imt2020532/Lookup-Table-Based-Design-of-High-PSRR-LDO-and-Automation-of-its-MOSFET-Sizing/README.md

Please wait for me to complete this code. As of now many of the things are hard coded and taken input manually. Will change this readme once changes are made.

Please change the paths of every csv file being used in the script! I have added the csv files here also in different directories.
