imt2020532/Lookup-Table-Based-Design-of-High-PSRR-LDO-and-Automation-of-its-MOSFET-Sizing/presentation.pptx

## Lookup Table Based Design of High PSRR LDO and Automation of its MOSFET Sizing

VL804 Analog Power IC Design
Anwit Suhas Damale IMT2020532
Nalamothu Sai Sampath MT2023525

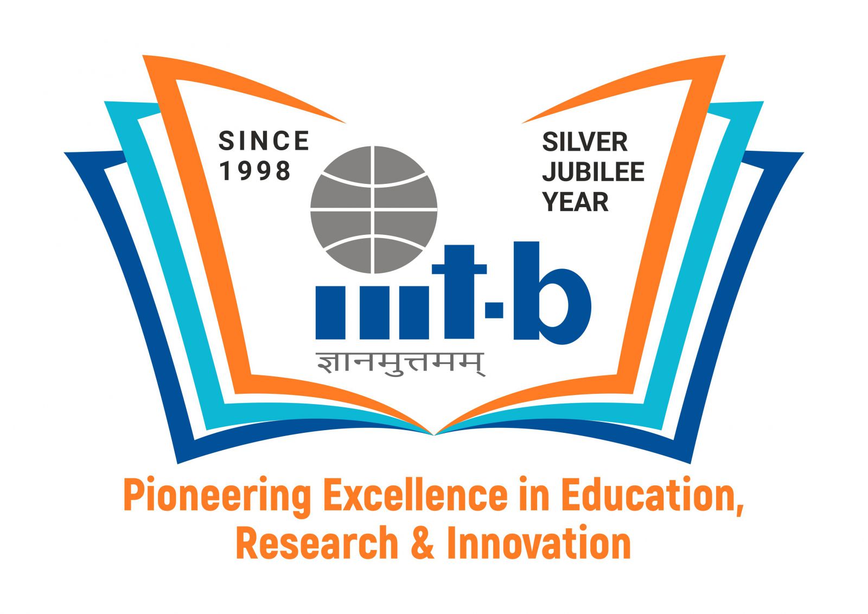
[picture p1: figure]

## Outline

1. Limitations of Square Law
2. gm/Id Methodology
3. LDO
4. Specification Table
5. Circuit Diagram
6. Design Flow
7. Limitations of gm/Id Methodology
8. Automation Design Flow
9. Results
10. Next Steps
11. References

## Limitations of Square Law

1. The square law fails to describe the weak inversion (sub-threshold) region.
2. The square law fails to describe strong inversion (saturation) region when short channel effects are taken into consideration.
3. Since there is a difference between an actual transistor behavior and the simple square law model, any square-law driven design optimization will be far off from simulation results

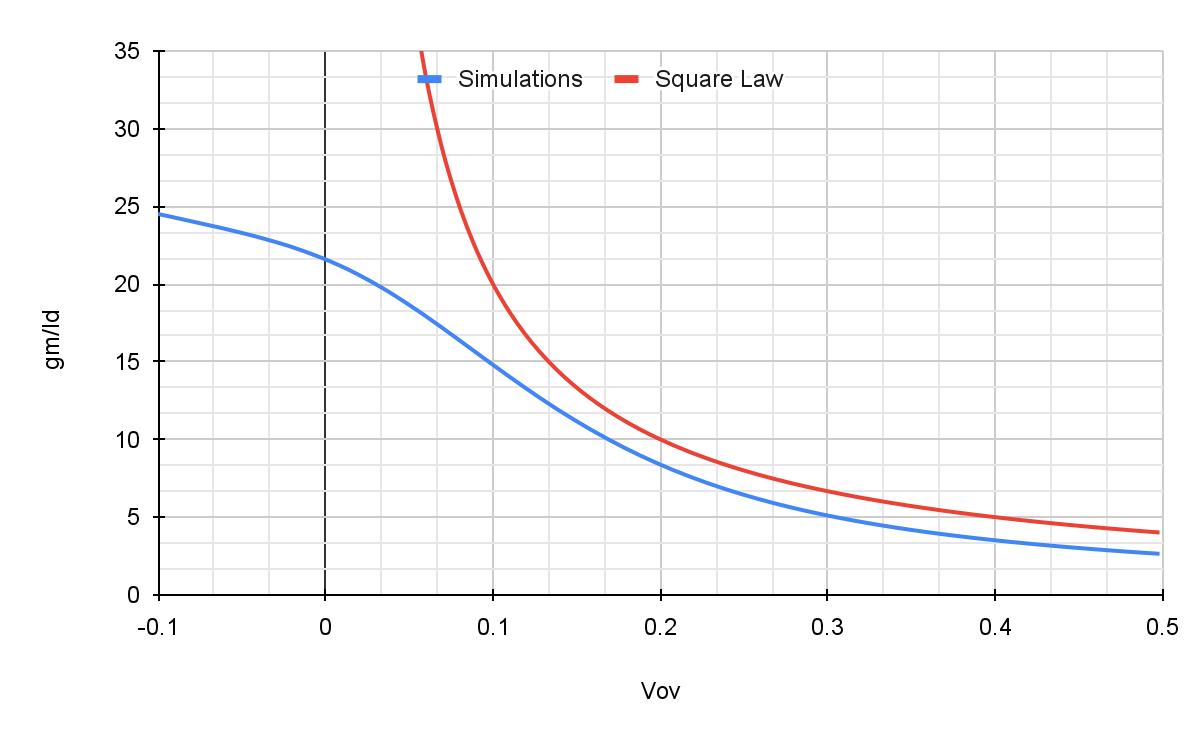
[picture p2: figure]

## Slide 4

gm/Id v/s Vov plot comparison for different technology nodes for their minimum lengths

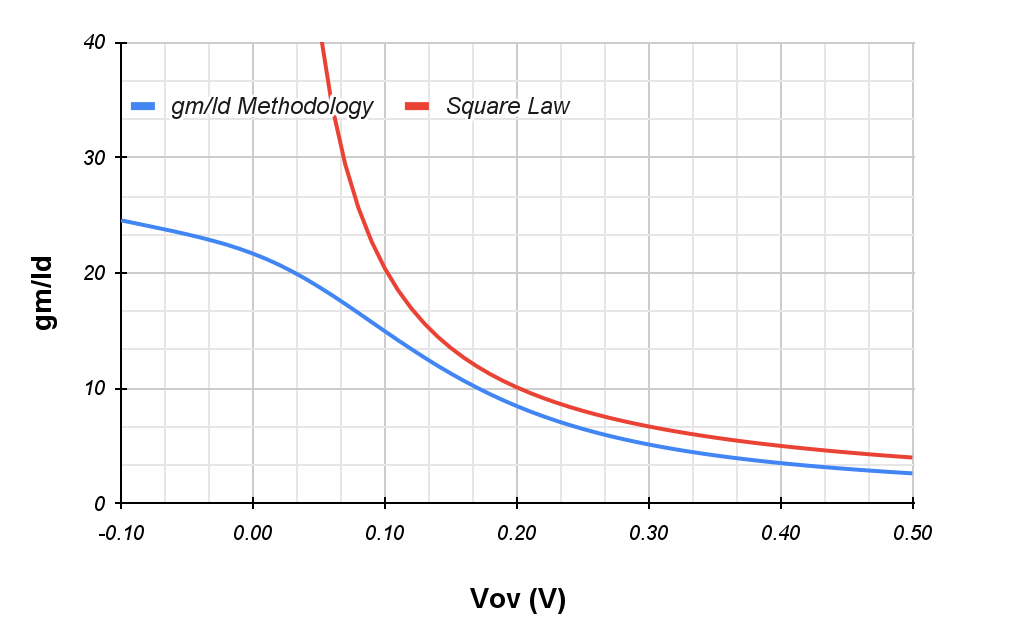
[picture p3: figure]

180nm technology node
Lmin = 180nm

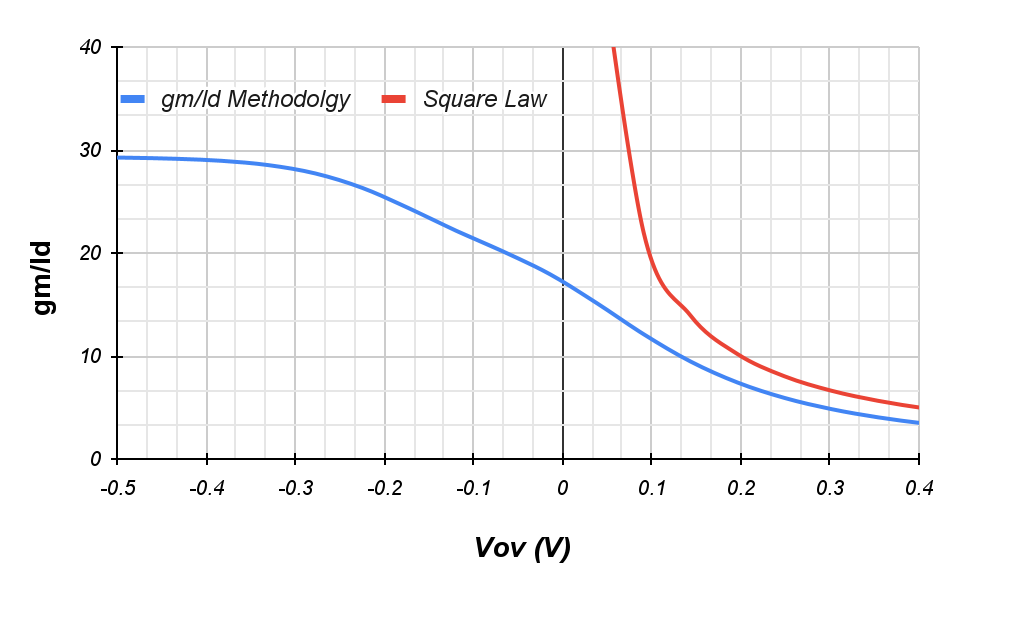
[picture p4: figure]

110 nm technology node
Lmin = 110nm

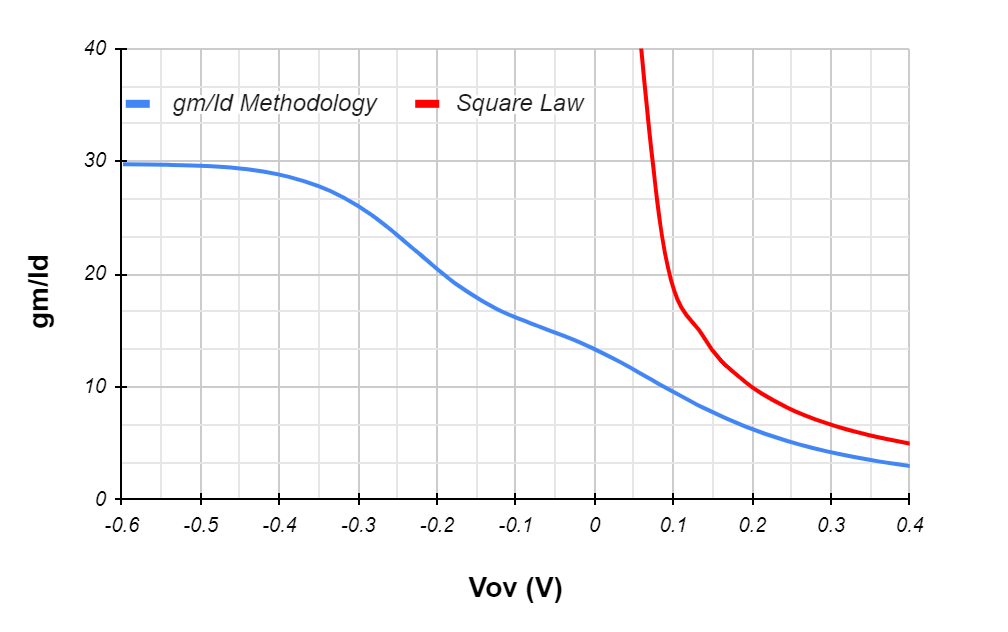
[picture p5: figure]

45nm technology node
Lmin = 45nm

- For a lower technology node of its respective minimum length the difference between gm/Id methodology and square is very large

## Slide 5

Comparison of Error (%) of gm/Id v/s Vov for different technology nodes

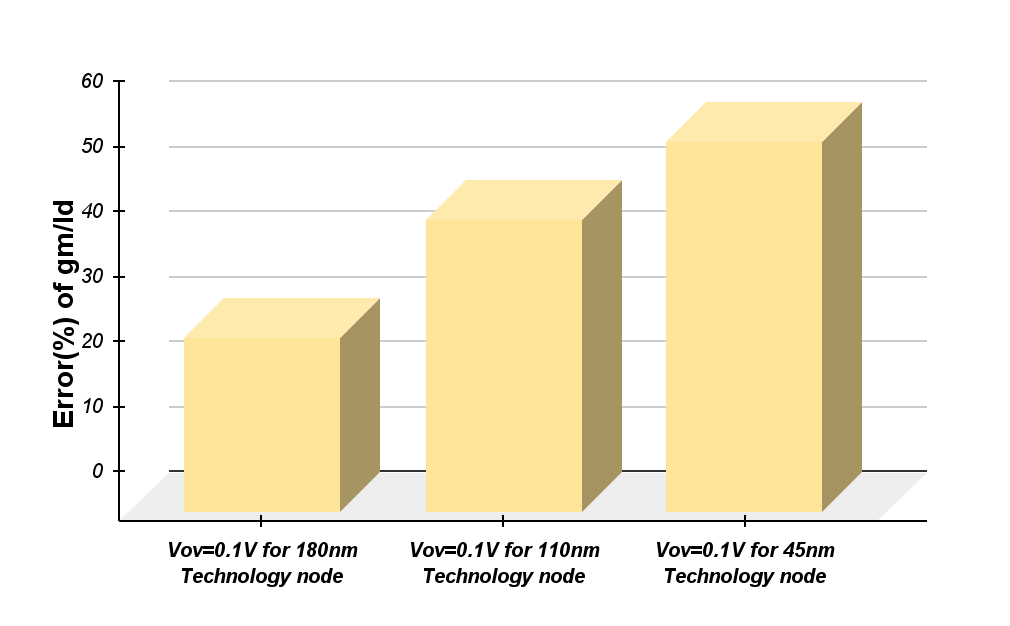
[picture p6: figure]

- For a lesser Vov value, the error (%) of gm/Id value of gm/Id methodology and Square Law is very high

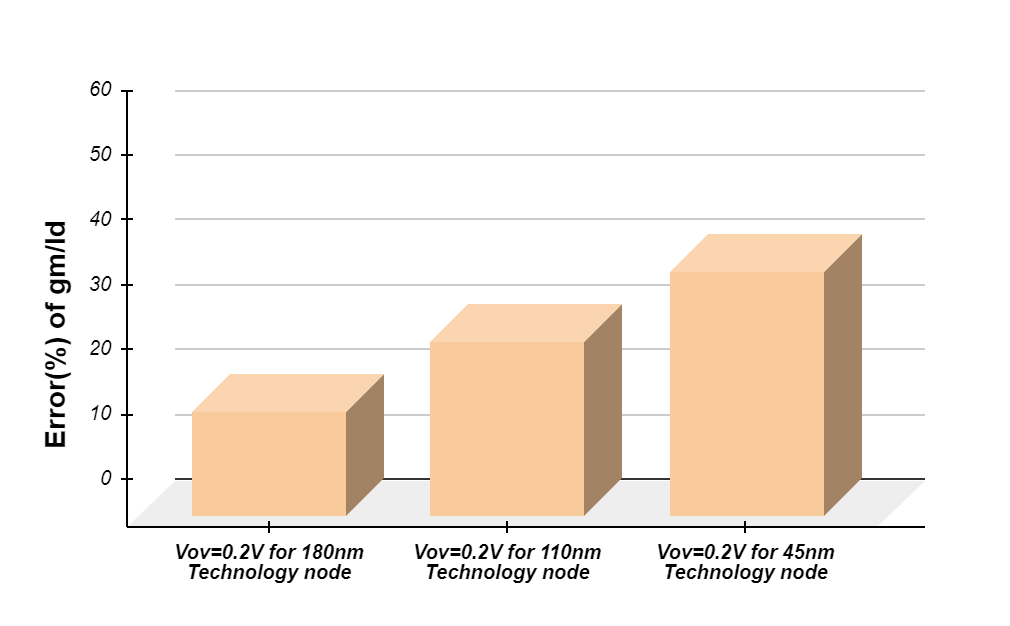
[picture p7: figure]

## Slide 6

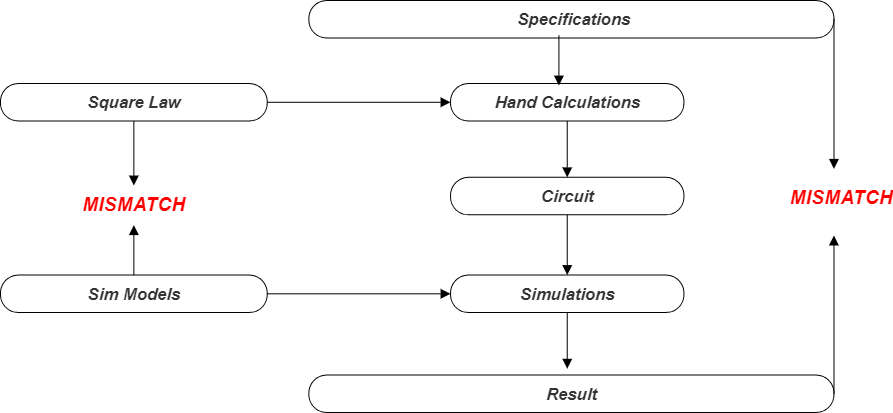
[picture p8: figure]

Square Law based Design

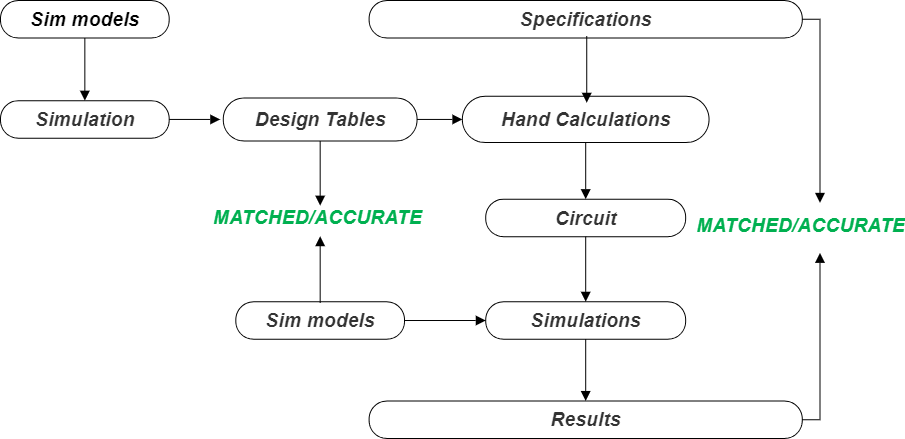
[picture p9: figure]

gm/Id methodology based Design

- gm/Id methodology gives more accurate results than Square Law

## gm/Id Methodology

gm/Id is a measure of the efficiency to translate current (i.e., power) into gm (i.e., gain). The greater gm/Id, the greater gm is for a fixed Id. gm/Id is interpreted as a measure of the “gm enhancement efficiency”.
1. It is strongly related to the performances of analog circuits.
2. It describes about the device region of operation.
3. It provides a tool for calculating the transistors dimensions.
4. The method exploits the transconductance over dc drain current ratio ( gm/Id) relationship versus the normalized current [Id/(W/L)].

## Slide 8

Advantages of gm/Id Methodology
1. gm/id curve is generated from SPICE simulation, which is linked to the actual measurement data
- Better match to the fabricated one
1. gm/id value does not rely on any model equation
- Avoid the design uncertainties
1. gm/id Value has fixed shape regardless of transistor length.
2. gm/id curve is valid all over the transistor operating range.
3. gm/id method can reduce the design and optimization effort a lot.
4. Once selecting one point from gm/id curve, with another design parameter the third parameter can be easily determined.

## Figure of merits (or) Performance metrics

1.Trans-conductor Efficiency: (Should be high)
It is the efficiency of the MOS transistor to translate given current into an equivalent transconductance.
TE = gm/Id
2. Intrinsic Gain: gm*ro
3.Transit Frequency (or Unity Gain Frequency):
WT=gm/Cgg
It is the maximum frequency beyond which MOS transistor will not act as amplifier.
All the above mentioned FOM's and Id/W are independent of widths.

## Slide 10

gm/Id plot comparison for different technology nodes of same length = 180nm

180nm technology node

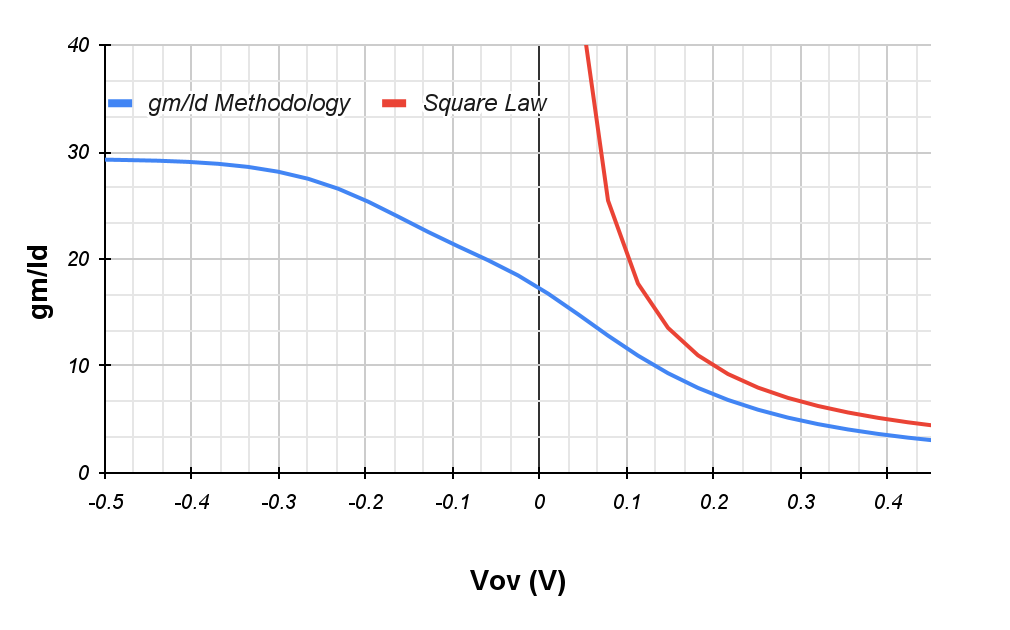
[picture p10: figure]

110 nm technology node

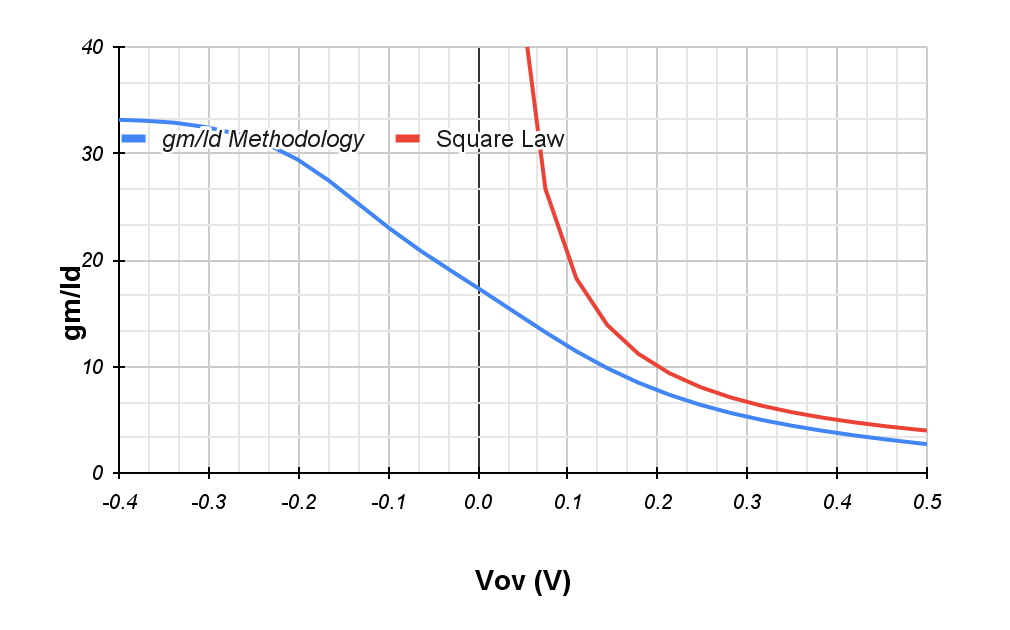
[picture p11: figure]

45nm technology node

- For any technology node if length increases the narrowness between gm/Id methodology and Square law gets decreased

## LDO

A voltage regulator with a small difference in voltage between input and output is called an LDO regulator. LDO stands for low dropout; an LDO regulator is a type of linear regulator with a low input-output voltage differential.

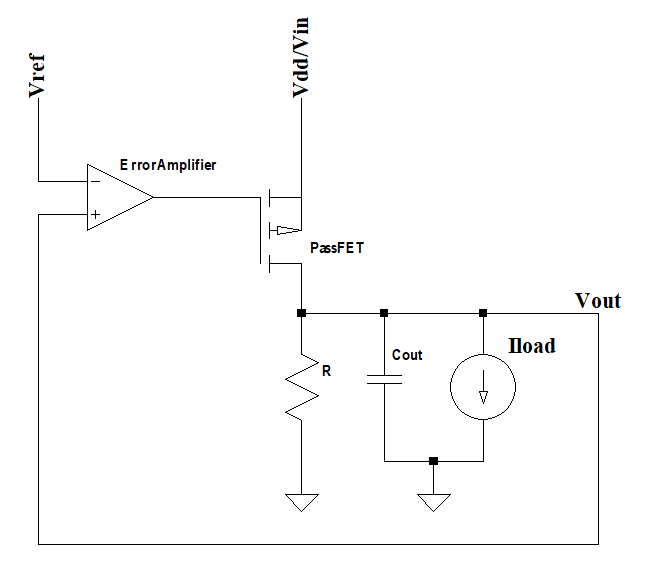
[picture p12: figure]

Linear regulator with unity feedback

## Regulator Performance Parameters

DC Regulation:
1. It is measure of an error in output voltage.
2. For good dc regulation high gain error amplifier, low offset error amplifier and a constant vref w.r.t. process, voltage and temperature is required.

## Slide 13

Line regulation:
1. It is a measure of error in output voltage due to change in the input supply (line)
Line Regulation = ΔVout / Δvin (at low freq)
Load regulation:
1. It is a measure of error in output voltage with change in load current.
Load Regulation = ΔVout / ΔIout
1. Cumulative high gain of error amplifier and passfet is desired for the good load regulation i.e less change in vout with change in load current.

## Slide 14

Line transient:
1. When there is up and down step change in line supply, it result in over and undershoot respectively in the vout of regulator. The reason is the feedback doesn’t respond quickly.
Line Transient = ΔVout / Δvin (step change)
1. For a good regulator, ΔVout because of line transient should be less than 5% of Vout and tsettle will be calculated when it will reach to 1% of Vout.
2. For a good line transient generally a large capacitor at output is used. Also feed forward from line is taken with feedback to decide the gate control of passfet and high bandwidth regulator is made for loop to respond faster.

## Slide 15

Load transient:
1. It is a measure of error in output voltage with step change in load current.
Load Transient = ΔVout / Iload (step change)
1. When there is up and down step change in load, it result in under and overshoot respectively in the vout of regulator.
2. The reason is the feedback doesn’t respond quickly and the capacitor draws and gets respectively the extra current.
3. Large capacitor and high bandwidth regulator is useful in less load transient.
4. Large Capacitor will act as transient filter because any fast change at output will be filtered out by it.

## Slide 16

Power supply rejection ratio (PSRR):
1. It is the ability to reject any change in vout w.r.t. ac change in vin.
PSRR = ΔVout/ΔVin
1. Large output capacitor value will allow less ripple to go at load. It is calculated in dB. A large –ve dB PSRR value is good.
Efficiency:
Efficiency w.r.t. Power = Pout/(Pout+Ploss)
Quiescent Current:
1. It is an internal current consumption of the regulator at no load condition. It should be as low as possible for better current efficiency.
2. Iq should be as minimum as possible from the design along with correct operation
Efficiency w.r.t. Current = Iout/(Iout+ Iq)

## Specification Table

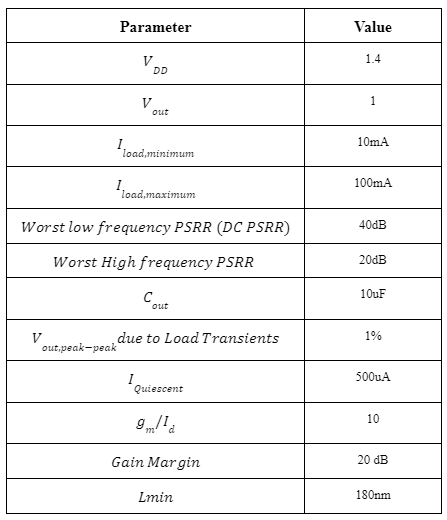
[picture p13: figure]

## Circuit Diagram

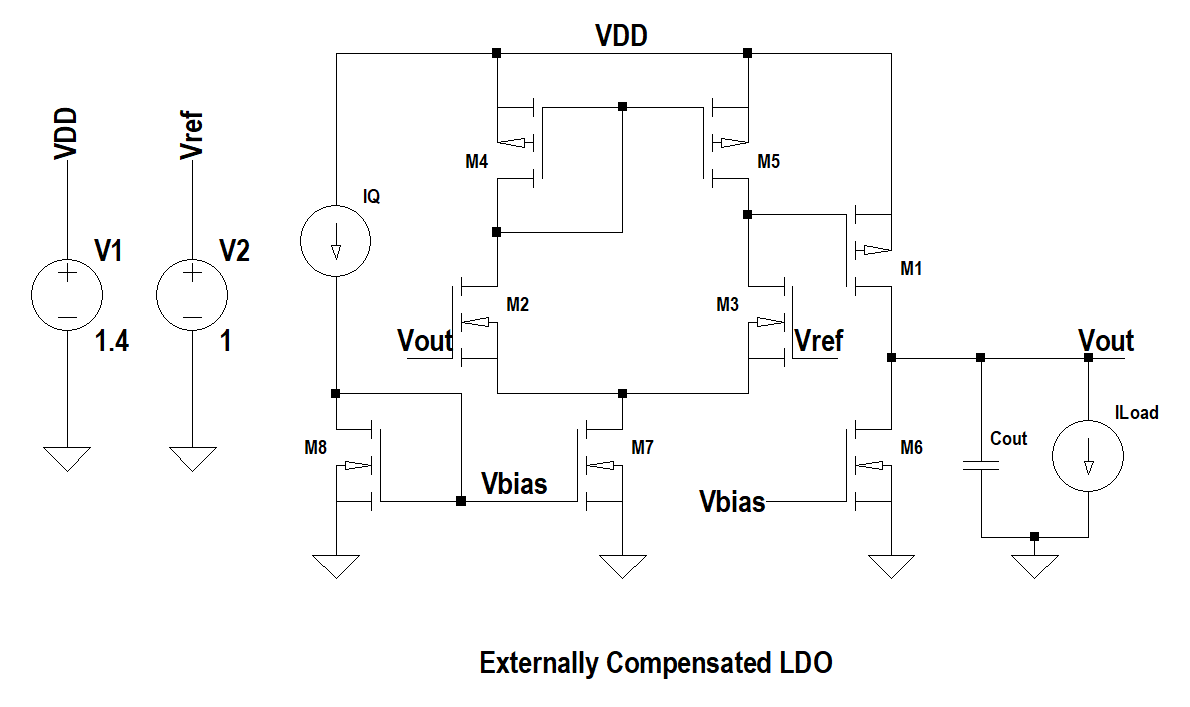
[picture p14: figure]

## Design Flow

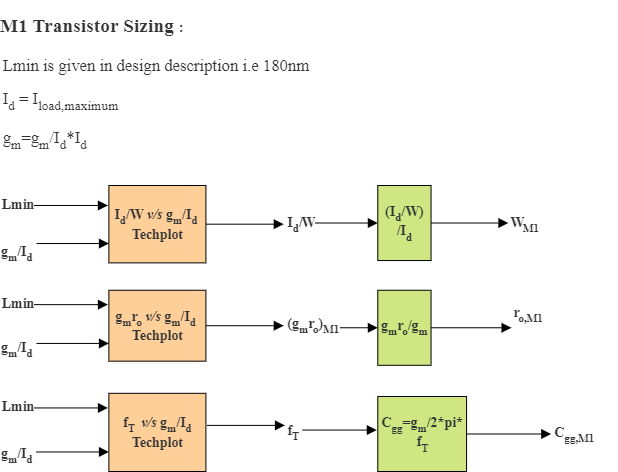
[picture p15: figure]

## Slide 20

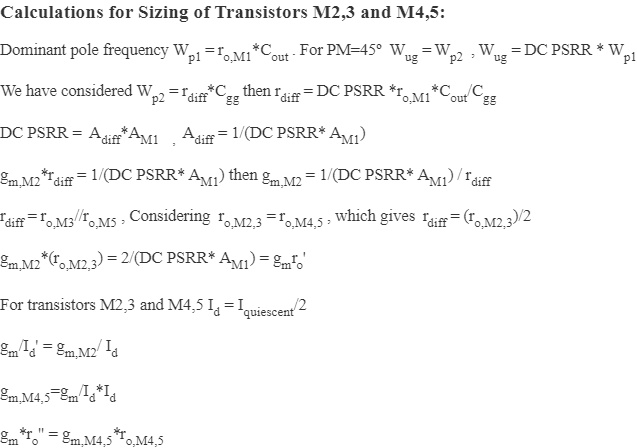
[picture p16: figure]

## Slide 21

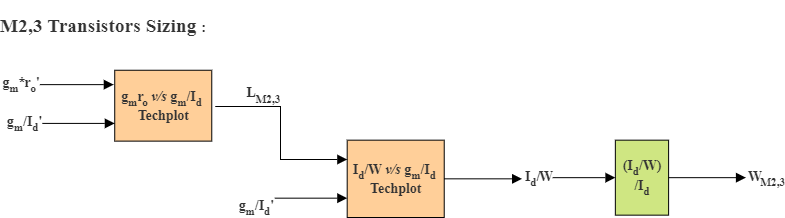
[picture p17: figure]
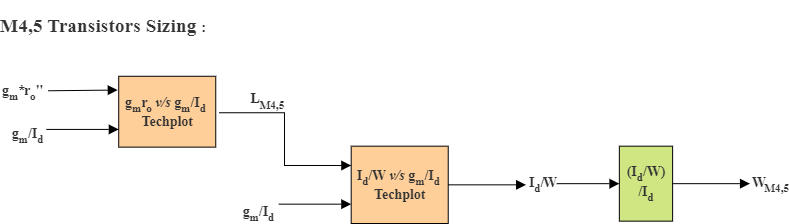
[picture p18: figure]

## Slide 22

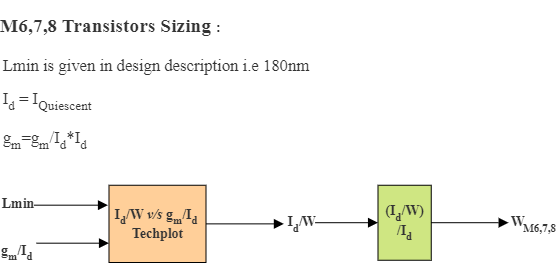
[picture p19: figure]

## Limitations of gm/Id Methodology

1. If we go for lower technology nodes the dependency of width comes into the picture where in general the parameters (FOM’S) are independent of width .
2. We are fixing the value of Vds for a certain value which in turn leads Vds mismatch in device and tech-plots.

## Automation Design Flow

- We are using the TechPlot_Sim_Data_180nm_VDS_0p4V.xlsx file as our tech-plot file.
- As of now we need to change the format of this file for our inputs to the automated Python script.
- The exact .csv format files and directories can be seen in the flow below.

## Slide 25

Format of Saving plots

Directories

Directories

Gm by Id vs gmro

csv files

M1 plot

L = 180 nm

Gm by Id vs Id by W

M2 plot

Tech-plot

Gm by Id vs gmro

L = 360 nm

Gm by Id vs Id by W

M1 to M8

For all Lengths

## Block Diagram of the Script

Script

Tech-plot

Specifications

Look-up table

Optimal Lengths and Widths of M1 to M8 Transistors

## Automation Design Flow - Script Sequence

The sequence in which the code works is :-
- First M1 Width, inputs are specification value gm by Id = 10.
- Second will be getting Width and Length of M2 and M3. The input will be both Gm_diff/I_diff and Gm_diff*ron_diff.

## Automation Design Flow - Script Sequence

The sequence in which the code works is :-
- Input will be gm/I_diff and gm*ron, then we will get the most suitable length.
- Then input gm/i_diff will give us Id/W as output. Now use specification table and get W.

## Automation Design Flow - Script Sequence

The sequence in which the code works is :-
- Similarly we get Width and Length of M4 and M5.
- We get Width of M6, M7 and M8 the same way we got M1 Width.

## Automation Design Flow - Code Functions

- This function performs linear interpolation to estimate the y-value corresponding to a given x-value within a set of data points (x_data, y_data) provided in CSV format.

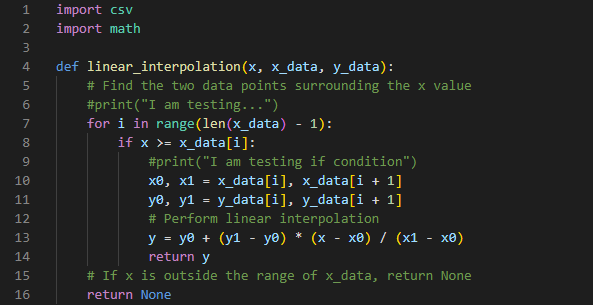
[picture p20: figure]

## Automation Design Flow - Code Functions

- This function calculates the minimum Euclidean distance between a point (x, y) and a curve defined by a set of points (x_curve, y_curve).

## Automation Design Flow - Example

- Use Specification table for giving inputs at every step and the look-up table for the formulae based calculations.

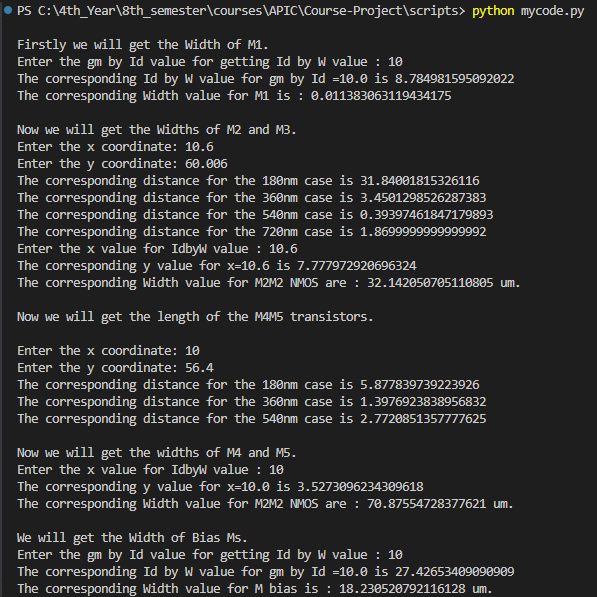
[picture p21: figure]

## Limitations of the Script

- The format of the tech plot needs to be manually changed.
- The inputs should be looked up for in the specifications table instead of getting them automatically.
- The intermediate formulae based calculations are not yet put in the code.

## Results

Transistor Sizing Comparison

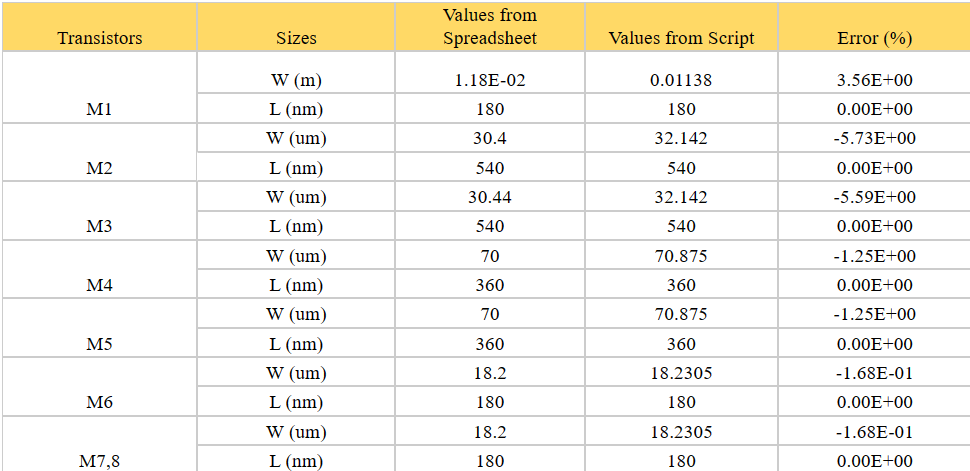
[picture p22: figure]

## Comparison of values generated from spreadsheet and scripting

## Next Step

- Making the script more automated with including formulae based calculations coded in it.
- Interpreting the tech plot format internally in the code itself.
- Taking inputs from specification table automatically.
- Making the entire process open source.

## References

1. F. Silveira et al. "A gm/ID based methodology for the design of CMOS analog circuits and its application to the synthesis of a silicon-on insulator micropower OTA," IEEE J. Solid-State Circuits, Sep. 1996, pp.1314-1319.
