imt2020532/Lookup-Table-Based-Design-of-High-PSRR-LDO-and-Automation-of-its-MOSFET-Sizing/DMC_2024.pdf

# Design and Automation Methodology of a Wideband, High-PSRR LDO using Device Look-up Tables

Sai Sampath¹

, Anwit Damale²

, Sakshi Arora³

and Manikandan R.R.⁴
Electronics and Communication Department International Institute of Information Technology Bangalore, India {saisampath.nalamothu, anwit.damale, sakshi.arora, manikandanrr}@iiitb.ac.in

Abstract—This work presents a Look-up Table (LuT)-based methodology for designing wideband, high Power Supply Rejection Ratio (PSRR) Low Dropout Regulators (LDOs). The proposed methodology has been automated using a Python script to produce optimal sizes for all LDO transistors. A high-PSRR LDO has been designed in 180-nm CMOS technology utilizing this methodology and its automation script. The LDO achieves a DC-PSRR of -60 dB, with a worst-case PSRR of -

### 36 dB across frequencies and load currents. Across the stability

performance metrics, an error percentage of less than 2.5% is achieved between calculated and simulated values. Therefore, this approach addresses the limitations of the traditional MOSFET square-law model while retaining analytical insights and design intuition, reducing design iterations and shortening the overall design cycle.
Index Terms—Look-up Table (LuT) methodology, LDO, Linear Regulators, wideband power supply rejection, CMOS design, Python script, PSRR, analog-design automation, gm/Id
I. INTRODUCTION

Using MOSFET square law for designing analog circuits can lead to significant differences between theoretical design calculations and simulated circuit behavior. This difference is more pronounced at sub-90-nm nodes and for low overdrive voltages. The gm/Id methodology [1], also known as the lookup table (LuT)-based design approach, offers a robust solution to size transistors for the given MOS Figures of merit, namely gm/Id, Id/W, ft and gmro, as it relies on the actual device characterization data [2]. However, different analog circuit blocks with various performance metrics require different LuTbased design flows [3]. Furthermore, the vast data set available with technology characterization can add complexity to LuTbased methods and demand automation incorporated into the overall design flow.
This work demonstrates a design and automation methodology for wideband high PSRR LDOs using technology LuTs. The proposed workflow follows two steps: In step 1, algorithms 1 and 2 take the design specification and derive the MOS FOMs. In step 2, these FOM values and technology LuTs are fed to the automation script, which automates the entire design flow to obtain optimum sizes for all transistors. Following this performance-specific design and automation flow, a strong correlation between circuit-design calculations and simulation results is achieved.

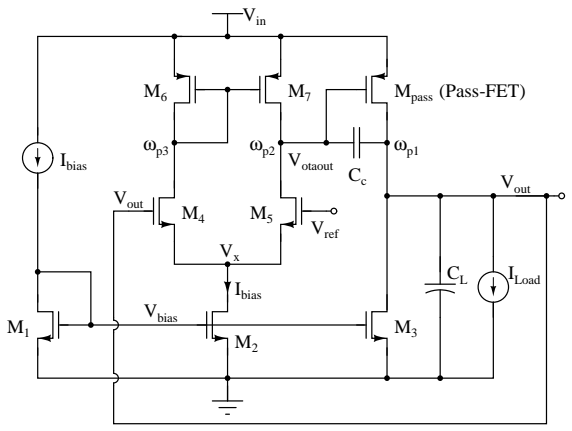
[picture p23: figure]
Vout; Vref; Ibias; Mpass; ILoad; Vin; Vbias; (Pass-FET); Votaout

Fig. 1. Externally-compensated PMOS-based LDO

The presented methodology enables creating and sharing standardized design flows, promoting collaboration among designers and, as a result, contributing to open-source design effort [4] [5]. This work uses automation scripts to streamline device sizing and reduce design time while preserving the analytical insights necessary for design accuracy [6]. Section II-A/B/C describes Algorithms 1 and 2, which are used to derive transistor FOMs from given performance specifications. Section II-D presents Algorithms 3 and 4, which take as input the above-derived FOMs and technology LuTs to produce optimum device sizes. Section III presents the correlation between the calculated and simulated performance of a wideband high PSRR LDO designed using the presented methodology. Section IV summarizes and concludes the work.

II. DESIGN-FLOW OF A HIGH-PSRR EXTERNALLY-COMPENSATED LDO USING DEVICE LUTS
Figure 1 shows an externally-compensated LDO with a PMOS Pass FET (also called PMOS-based LDO). The following sections discuss the step-by-step description of the proposed design methodology:
A. Sizing the pass transistor, Mpass
The LDO pass-FET is sized to support maximum load current and (gm/Id = 10), which is a proxy for Vov = 200mV from conventional square-law paradigm. Minimum channel length, Lmin = 180nm is used to minimize the device area. Algorithm 1 shows the detailed steps to compute the width of the pass-FET, Wpass, and also to calculate its small-signal parameters: gmpass, (rOpass = rout,p1), and Cggpass. In this step, the pass-FET intrinsic gain and output-pole frequency, ωp1, are also calculated.
B. Worst-case load condition
Determining the dependence of LDO small-signal performance metrics on load conditions is critical to this design flow and is summarized via the equations below.
The loop gain, ALG, is expressed as the product of the gain of the pass transistor, Apass and the error-amplifier gain, Adif f and is given by:

ALG

DC = (gmpassrOpass) · [gm4(rO5 k rO7)] (1)

where gmpass · rOpass is the intrinsic gain of the pass FET, gm4 and (rO5 k rO7) are the transconductance and output resistance of the error-amplifier, respectively. The dominant pole, set by the output stage of the LDO, is given by:

ωp1 ≈

1

rOpassCL

∝ ILoad | (2)

The non-dominant pole, ωp2, is set by the error-amplifier output and is given by:

ωp2 =

1

(rO5 k rO7) · Cggpass
(3)

The unity-gain bandwidth, ωugb, is proportional to the gm of the pass transistor and error-amplifier gain, Adif f :

ωugb ∝

gmpass · Adif f
CL
∝

p
ILoad | (4)

As the load current, ILoad, increases, the dominant pole, ωp1, and the unity-gain bandwidth, ωugb, increase and move closer to the second pole at the error-amplifier output, ωp2. Therefore, the worst-case phase-margin of an externally-compensated LDO is at heavy or maximum load current.

C. Sizing of error-amplifier transistors
The DC-PSRR of PMOS LDO can be approximated [7] as,
PSRRDC = −20 log10(ALG,dc) | (6)

where ALG,dc is the DC loop gain. From the given DC-PSRR specification, ALG,dc can be evaluated from equation
(6) which is then used to calculate Adif f and the other stability metrics as shown in Algorithm 2. As an example, to achieve a phase-margin of ≥ 45°:

ωp2 =

ALG,dc

ωp1|Heavy
=

ALG,dc
1
rOpass|Heavy·CL

(8)

Algorithm 2 illustrates the design flow for the NMOS input pair (M4,5), where gm/Id is set by the Ibias specification,

Algorithm 1 Sizing the Pass FET (Mpass)
Given the load circuit parameters CL and Iload,max, 1: Set (gm/Id) and Lpass to the following values,
- Set

gm
Id
= 10
- Set Lpass = Lmin = 180-nm 2: Lookup Tables (LuTs):
- Extract transistor F oM’s at

gm
Id
= 10 from the
following LuT’s,
– Intrinsic gain LuT → (gm · ro) versus

gm
Id
– Transit frequency LuT → fT versus

gm
Id
– Current density LuT →

Id
W

versus

gm
Id
3: Computation block:
- Calculate pass-FET small signal parameters from the extracted FoM values,

– gmpass =

gm
Id
- Iload,max

– rOpass =

h
(gm·ro)

gmpass i
and Cggpass =
gmpass
fT

– ωp1 =

1
rOpass·CL

– Wpass =

h
Iload,max

IdW

i

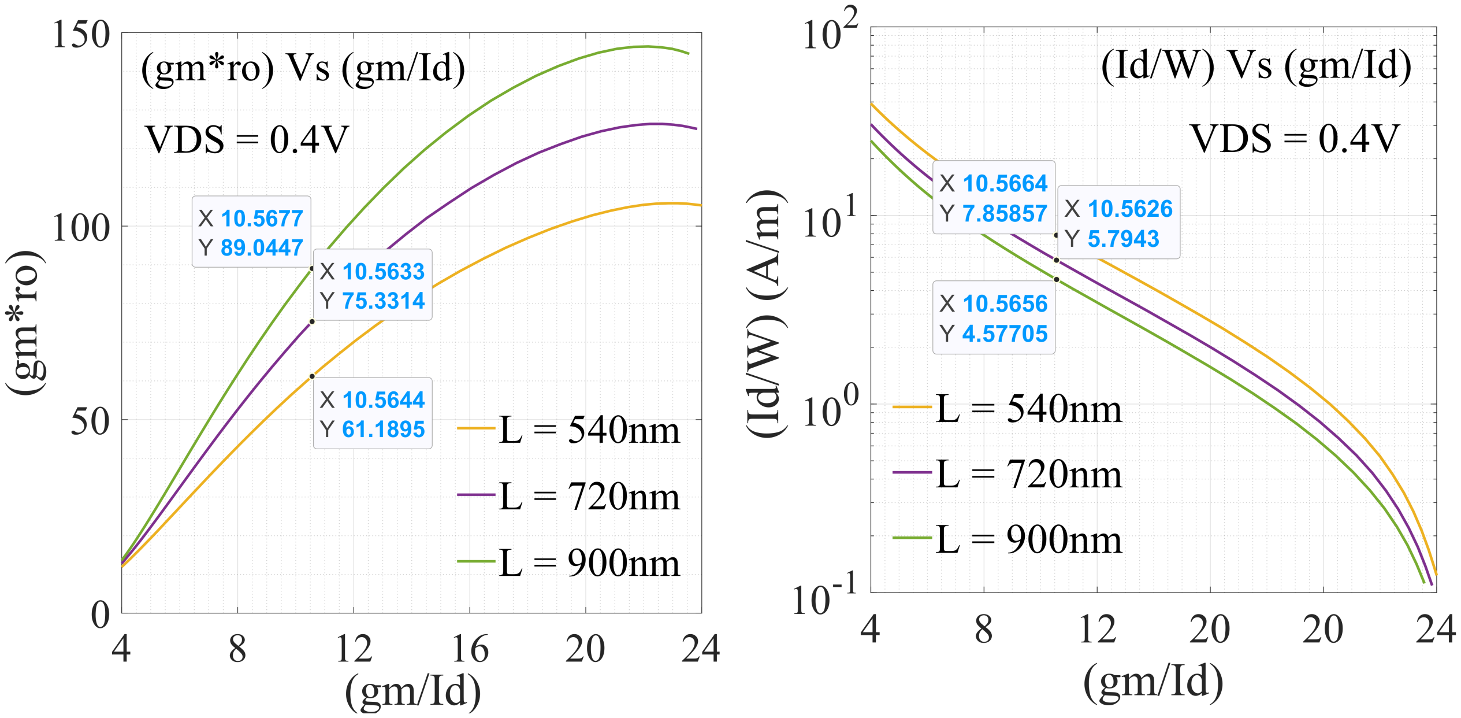
[picture p24: figure]

(a) (b)

Fig. 2. Device Lookup Table (LuT) plots generated for an NMOS transistor in 180-nm CMOS process technology.

and gm4,5, which is derived from the pass-FET intrinsic gain and the error-amplifier output resistance.
For the PMOS-transistor load, M6,7, the flow follows a similar approach to that of the pass-FET. Id,6,7 current is set to (Ibias/2) and (gm/Id) ratio matched to that of pass-FET. However, in the case of the PMOS load, we utilize technology plots where the drain-source voltage (Vds) is approximated as (Vth + Vov) ≃ 0.6V in the design example.
In this design, for the bias transistors, M1,2,3, the lengths and gm/Id are chosen to be same as that of M4,5. Transistor widths, W1,2,3 are computed using the steps outlined in Algorithm 1.
D. Automation script for MOSFET sizing
Figure 3 shows the block level description of the ‘LDO-(gm/Id)’ design flow script. The script takes design speci-

Algorithm 2 Sizing the error-amplifier transistors (M4,5) 1: Input parameters:

- gmpass · rOpass
- Cgggpass
- Output pole frequency, ωp1
- Ibias or IQ
2: Computation block:
- Calculate the error-amplifier transistors’ small signal parameters from the given input parameters,

– Adif f

DC =

h ALG

DC
(gmpass·rOpass)

i

– ωugb =

ALG

DC · ωp1

– (ro5||ro7) =
1

Cgggpass·ωugb

– ωp2 =

h
1

(ro5||ro7)·Cgggpass i

– gm4 = gm5 =

h
Adiff
(ro5||ro7)

i

– (gm · rO) = -gm4 · 2 · (rO5||rO7)

–

gm
Id
=

h
gm4

(Ibias/2) i

3: Lookup Tables (LuTs):
- Find the channel length of transistors M4,5 to meet the calculated (gm · rO) requirement.
- Extract transistor F oM’s at the calculated

gm
Id
from
the following LuT’s,
– Transit frequency LuT → fT versus

gm
Id
– Current density LuT →

Id
W

versus

gm
Id
4: Transistor Width (M4,5):
- Calculate W4,5 → W4,5 =

h
(Ibias/2)

IdW

i

fications and technology LuTs as inputs, and gives out the optimum dimensions for all LDO transistors. The LuTs are in the form of a ‘CSV’ file with the following MOSFET FOMs: intrinsic gain, (gm · ro), current density (Id/W), and transit frequency (fT ), characterized against the trans-conductance efficiency (gm/Id).
Algorithm 1 & 2 are included as computational blocks in this design-automation script.
As a next step, device aspect ratios need to be computed for a derived gmro or ft FOM. To perform this, we need to access technology plots (shown in Fig.2), which can be either limited or too vast to handle. In order to address these concerns, this script uses two functions:
- The ”linear interpolation” function is useful to estimate an intermediate value from a given set of discrete data points. In the ’LDO-gm/Id’ design flow, this function interpolates the FOM values for a given gm/Id in a limited channel-length techplot set. For example, in Fig.2 the function will find gmro values for multiple finer length steps at a gm/Id = 10.56.
- The ”distance between a point and a curve” function

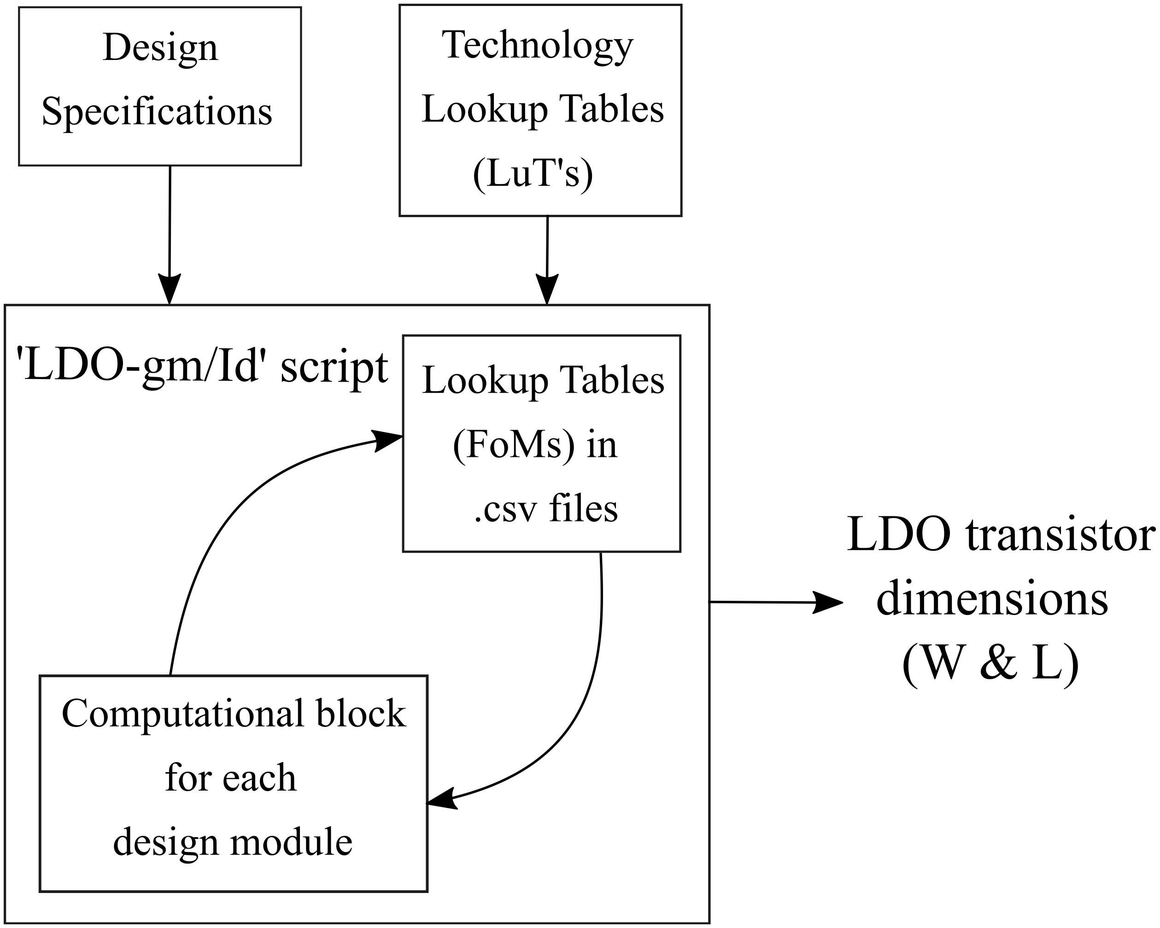
[picture p25: figure]

Fig. 3. Block-level description of the ‘LDO-(gm/Id)’ design flow script.

calculates the Euclidean distance between a target FOM point and a set of data points on a curve. For example, the function will find the optimum channel length for the derived gmro.

In summary, to find transistor channel length for desired intrinsic gain (gm · ro), the script does the following: Using the LuT data of ‘gmro vs. gm/id’ the interpolation function estimates gm·ro for a given (gm/Id) at all channel lengths. The distance-to-curve function then calculates the distance between the target and all the gm·ro points and then selects the channel length with the smallest distance to target gm·ro curve. ‘LDO-(gm/Id)’ design flow script is implemented using Python which is shared here: Github link (https://github.com/imt2020532/Lookup-Table-Based-Design-of-High-PSRR-LDO-and-Automation-of-its-MOSFET-Sizing.git) [8].

Algorithm 3 Linear Interpolation
1: Input parameters:
- input point, x →

gm
Id
- x-coordinates, xdata → array of

gm
Id
values
- output point, y → interpolated (gm · rO)
- y-coordinates, ydata → array of (gm · rO) values 2: Process:
3: for each i from 1 to -len(xdata) − 1
do
4: | if x ≥ xdata[i] then
5: | Set x0 = xdata[i], x1 = xdata[i + 1]
6: | Set y0 = ydata[i], y1 = ydata[i + 1]
7: | Perform linear interpolation,
8: | y = y0 +

h
| (y1−y0) (x1−x0) · (x − x0)

i

9: | Return y
10: | end if
11: end for
12: Output:
| • y → (interpolated y-coordinate for the given x)

III. SIMULATION RESULTS AND DISCUSSION
In order to validate the proposed LDO design automation methodology using LuTs, an example design with specifica-

Algorithm 4 Distance Between a Point and a Curve 1: Input parameters:
- x-coordinate of the input point, x →

gm
Id
- y-coordinate of the input point, y → (gm · rO)
- x curve → array of x-coordinates of the curve
- y curve → array of y-coordinates of the curve 2: Process:
3: Initialize min distance = ∞
4: for each i from 1 to len(x curve) do
5: | Calculate distance between point (x, y) and curve point
| (x curve[i], y curve[i]):
6: distance =

p
| (x curve[i] − x) 2 + (y curve[i] − y)
| 2
7: | if distance < min distance then
8: | Update min distance = distance
9: | end if
10: end for
11: Output:
| • min distance (minimum distance between the point
| and the curve)

TABLE I
TECHNOLOGY LOOKUP TABLE PARAMETERS AND DIMENSIONS OF LDO TRANSISTORS (M1−7) & Mpass.
Transistor | gm/Id (1/V ) | gmrO | Id/W (A/m) | fT (GHz) | L (µm) | W (µm)
Mpass | 10 | 32.361 | 8.834 | 5.76 | 0.18 | 1132
M4,5 | 10.56 | 75.33 | 5.799 | 1.49 | 0.72 | 4.31
M6,7 | 10 | 60 | 9.04 | 5.96 | 0.18 | 2.7
M1,2,3 | 10.56 | 75.33 | 5.799 | 1.49 | 0.72 | 8.62

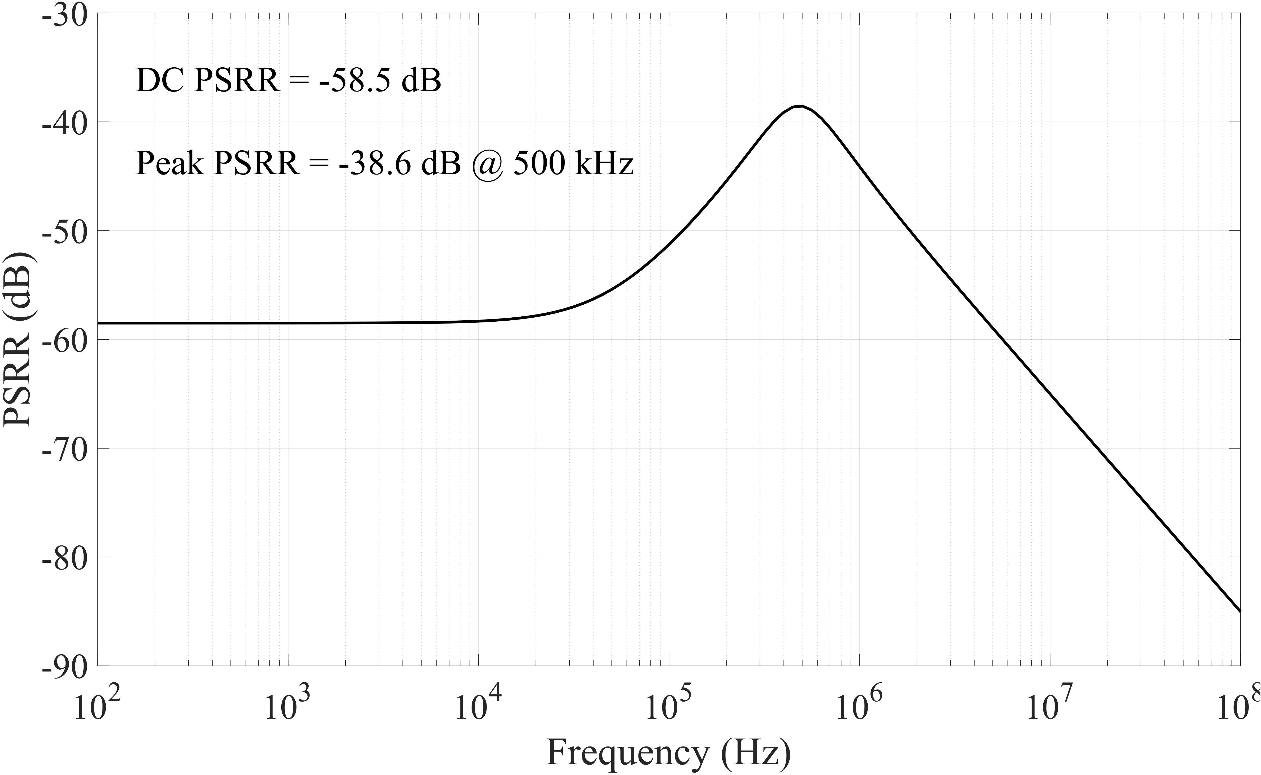
[picture p26: figure]

Fig. 4. Simulated PSRR performance, Vin = 1.4 V , Vout = 1.0 V , ILoad = 10 mA, Ibias = 50 µA, and CL = 1 µF.

tions Vin = 1.4 V , Vout = 1 V , ILoad = 10 mA, and a wideband PSRR of < −30dB, is designed and simulated in a 180-nm CMOS process technology. Figure 1 shows the schematic of the PMOS-based LDO. The pass-FET (Mpass) is sized to support a maximum load current of 10 mA. Error amplifier transistors (M4−7) and CL are designed to meet the wide-band PSRR specifications, as discussed in section II. Bias transistors (M1−3) are sized for a drain-to-source current of 50 µA, with its length and
gm/Id
kept same as that of M4,5. Table I

TABLE II
COMPARISON OF CALCULATED AND SIMULATED STABILITY METRICS WITH ERROR PERCENTAGE
| Calculated | Simulated | Error (%)
Adiff · Apass DC loop gain = | 1000, 60 dB | 1000, 60 dB | 0%
1 fp1 ≈ 2πrOpassCL | 489 Hz | 485 Hz | 0.82%
h 2π(rO5||rO7)Cggpass i 1 fp2 ≈ | 489 kHz | 478 kHz | 2.3%
fugb ≃ 0.787 · fp2 | 384 kHz | 379.6 kHz | 1.16%
Phase margin | 51.8o | 51.5o | 0.58%

shows the technology LuT parameters and the dimensions for LDO transistors, obtained from the ‘LDO-(gm/Id)’ design flow script. Pass-FET and the LDO circuit are estimated to occupy an on-chip area of 400 µm²

and ≃ 490µm²
respectively.
Table II shows the calculated and simulated stability metrics. Figure 4 shows the simulated PSRR performance of the LDO, with a high DC-PSRR of -58.5 dB, and with a peak PSRR of -38.6 dB at 500 kHz. The LDO supports a maximum load of 10 mA with an output capacitor of 1 µF, maintaining stability across load conditions. Table II validates the correlation between calculated and simulated performance of the proposed ‘LDO-(gm/Id)’ design methodology. The comparison is tabulated for DC loop gain, pole frequencies, unity-gain frequency and phase margin. Across these metrics, the predicted stability performance has an error of < 2.5%.

IV. CONCLUSION
The ’LDO-gm/Id design methodology’ presented in this work achieves a strong correlation of performance between design calculations and simulation results. The demonstrated design and automation flow is adaptable to advanced technology nodes and reduces number of analog design iterations. With the emerging usage of open-source PDKs, methodologydriven designs like this work, can be shared more widely, benefiting the broader analog IC-design community [8].

REFERENCES

[1] F. Silveira, D. Flandre, and P. Jespers, “A (gm/id) based methodology for the design of cmos analog circuits and its application to the synthesis of a silicon-on-insulator micropower ota,” IEEE Journal of Solid-State Circuits, 1996.
[2] P. Jespers, “The (gm/id) methodology, a sizing tool for low-voltage analog cmos circuits,” Springer, 2010.
[3] P. G. A. Jespers and B. Murmann, “Systematic design of analog cmos circuits using pre-computed lookup tables,” Cambridge University Press, 2017.
[4] B. Murmann, “Democratizing ic design: The story of a new movement and the launch of the sscs pico program [society news],” IEEE Solid-State Circuits Magazine, 2021.
[5] J. Marin, J. Gak, C. A. Rojas, A. H. Wilson-Veas, N. Calarco, M. Miguez,
A. R. Oliva, and N. Salvador, “Open-source multilevel converter power ic design and test,” IEEE Design Test, 2024.
[6] B. Murmann, “Practical aspects of script-based analog design using precomputed lookup tables,” in 2024 IEEE International Symposium on Circuits and Systems (ISCAS), 2024.
[7] V. Gupta and G. Rincon-Mora, “A low dropout, cmos regulator with high psr over wideband frequencies,” in 2005 IEEE International Symposium on Circuits and Systems, 2005.
[8] An example wideband PSRR LDO circuit designed using the proposed methods in this work and the Python scripts can be found in the following Github, link. (https://github.com/imt2020532/Lookup-Table-Based-Design-of-High-PSRR-LDO-and-Automation-of-its-MOSFET-Sizing.git)
