imt2020532/Lookup-Table-Based-Design-of-High-PSRR-LDO-and-Automation-of-its-MOSFET-Sizing/specs.xlsx

parameters | value | Unit
Vdd | 1.4 | V
Vout | 1 | V
I_load,min | 10 | mA
I_load,max | 100 | mA
Worst Low Frequency PSRR (DC PSRR) | 40 | dB
Worst High Frequency PSRR | 20 | dB
C_out | 10
V__out_peak_to_peak due to load transients | 1% | uA
I_quiescent(less than value given) | 500
