imt2020532/Lookup-Table-Based-Design-of-High-PSRR-LDO-and-Automation-of-its-MOSFET-Sizing/LTSpice/LDO_Load_Transient_Analysis.asc

C2: cap; {Co}
I1: current; {ibias}
Iload: current; PULSE(10m 100m 1u 200n 200n 1m 2m 10)
M1: nmos; nmos292p; L=Linput W=Winput
M2: nmos; nmos292p; L=Linput W=Winput
M3: nmos; nmos292p; L=0.18u W=18.2u
M4: pmos; pmos292p; L=Lload W=Wload
M5: pmos; pmos292p; L=Lload W=Wload
M7: nmos; nmos292p; L=0.18u W=18.2u
M8: nmos; nmos292p; L=0.18u W=18.2u
MPass: pmos; pmos292p; L=0.18u W=Wpass
V1: voltage; 1.4; AC 1
V2: voltage; 1
Named nets: 0, Bias, OUT, Vdd, Vref, OTAout
.include models_292p.txt
;.ac dec 20 10 1G
;.op
.tran 4m
.param ibias=500u
.param Linput=540n Lload=360n
Please set the parameters in all the .param statements below
.param Wload=70u
.param Winput=30.4u
.param Wpass=11800u
Also, set the capacitance values
;step param Co 10u 100u 10u
.param Co=10u
