imt2020532/Lookup-Table-Based-Design-of-High-PSRR-LDO-and-Automation-of-its-MOSFET-Sizing/LTSpice/LDO_loopgain_Analysis.asc

C2: cap; 10µ
C3: cap; 1
I1: current; {ibias}
Iload: current; {Iload}
M1: nmos; nmos292p; L=Linput W=Winput
M2: nmos; nmos292p; L=Linput W=Winput
M3: nmos; nmos292p; L=0.18u W=18.2u
M4: pmos; pmos292p; L=Lload W=Wload
M5: pmos; pmos292p; L=Lload W=Wload
M7: nmos; nmos292p; L=0.18u W=18.2u
M8: nmos; nmos292p; L=0.18u W=18.2u
MPass: pmos; pmos292p; L=0.18u W=Wpass
R1: res; 1G
V1: voltage; 1.4; AC 0
V2: voltage; 1
V3: voltage; 0; AC 1
Named nets: 0, Bias, OUT, Vdd, Vref, OTAout
.include models_292p.txt
;step param Iload 10m 100m 50m
.ac dec 20 10 1G
;.op
.param ibias=500u
.param Linput=540n
;tran 400u
Please set the parameters in all the .param statements below
.param Wload=70u
.param Winput=30.4u
.param Wpass=11800u
 
.param Iload=100m
Also, set the capacitance values
You can also use the middlebrook mthod to find the stability.
Please set the parameters in all the .param statements below
The method here of breaking the loop and evaluating loop gain works well for a high impedance node, but not always.
Middlebrook method is the best way to go. You can find an example in the educational folder of examples in LTspice folder.
AC analysis
.param Lload=360n
